serega3453/open-hotas/Models/Main-board/FCStd/Main_board_case.FCStd

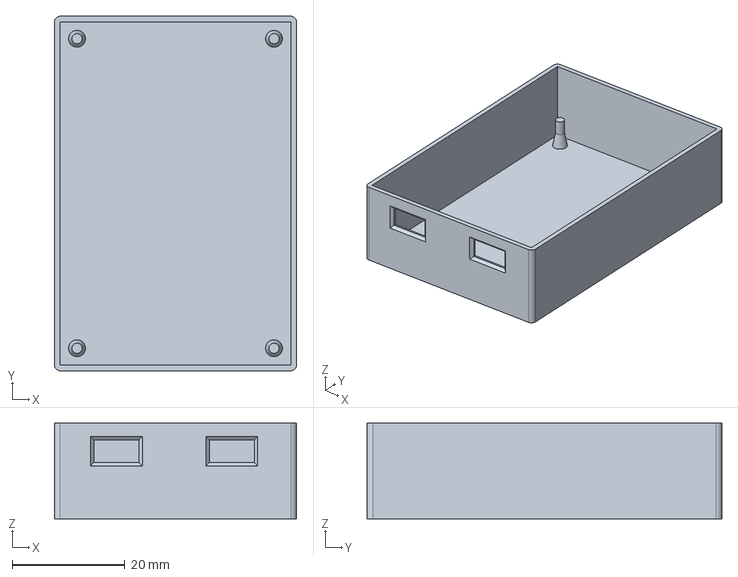
[picture p1: CAD file, 2026-10-18]
Models/Main-board/FCStd/Main_board_case.FCStd
43.0 x 63.0 x 17.0 mm
