serega3453/open-hotas/Models/Stick/FCStd/Main_stick_alternative.FCStd

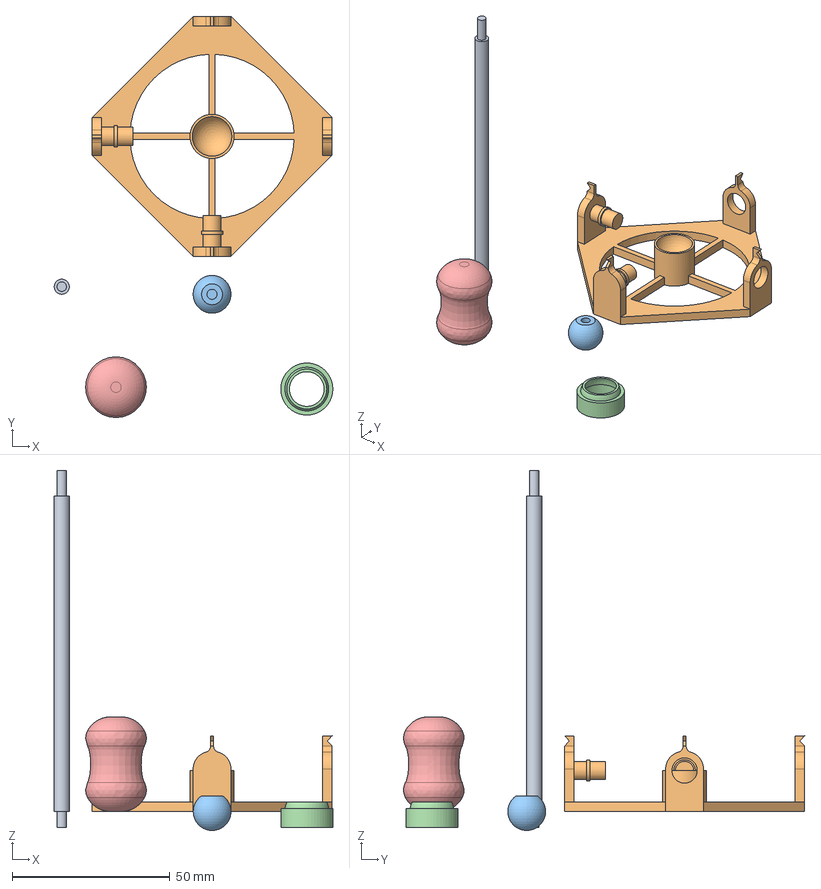
[picture p2: CAD file, 2026-10-15]
Models/Stick/FCStd/Main_stick_alternative.FCStd
88.2 x 127.0 x 114.0 mm
Stick_alt
Base
Stick_ball
Stick_ball_bracket
Stick_knob
