serega3453/open-hotas/Models/Selector-panel/FCStd/Joystick_module.FCStd

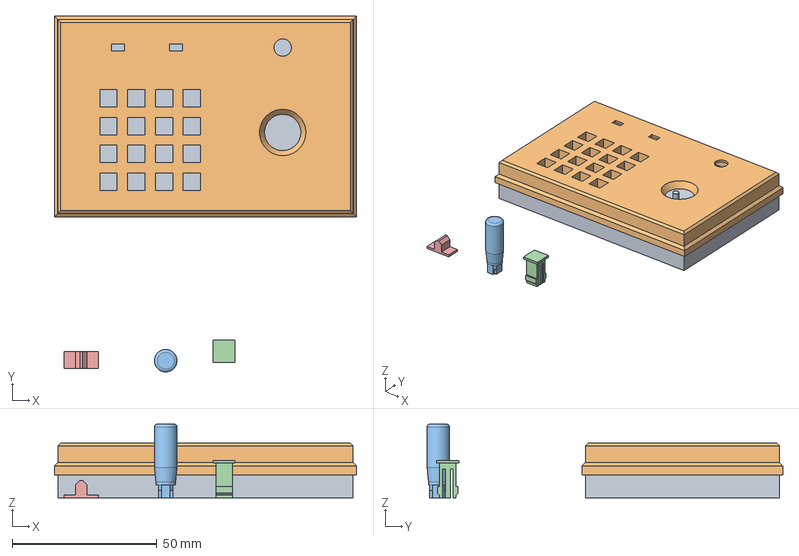
[picture p3: CAD file, 2026-10-10]
Models/Selector-panel/FCStd/Joystick_module.FCStd
104.4 x 122.9 x 25.5 mm
Cover
Stick
Plunger
Slider
