serega3453/open-hotas/Models/Stick/FCStd/New/Ergonomic_handle.FCStd

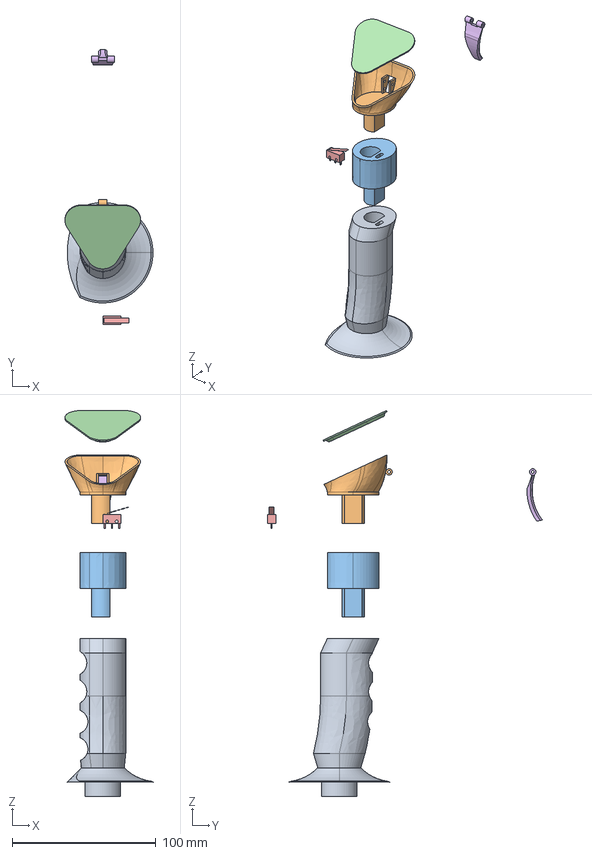
[picture p4: CAD file, 2026-11-05]
Models/Stick/FCStd/New/Ergonomic_handle.FCStd
61.3 x 191.5 x 268.8 mm
Ergonomic_handle
Erghonomic_handle_head
Ergonomic_handle_extender
Ergonomic_handle_head_cover
Microswitch
Trigger
