serega3453/open-hotas/Models/Stick/FCStd/potentiometer.FCStd

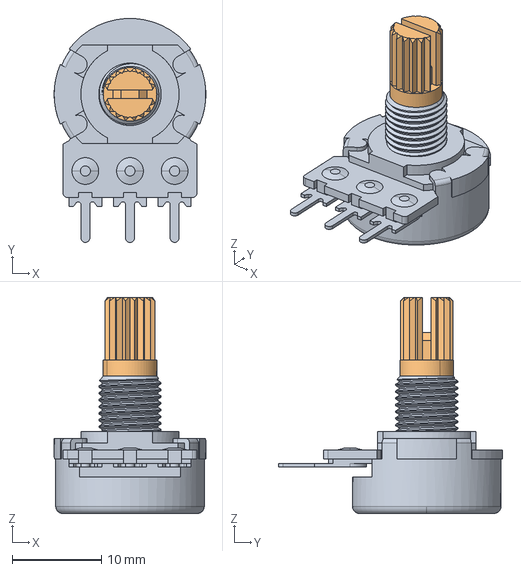
[picture p5: CAD file, 2026-11-04]
Models/Stick/FCStd/potentiometer.FCStd
17.0 x 25.1 x 24.2 mm
Slice005.10
