serega3453/open-hotas/Models/Stick/STL/Arcs/Outer_arc.stl

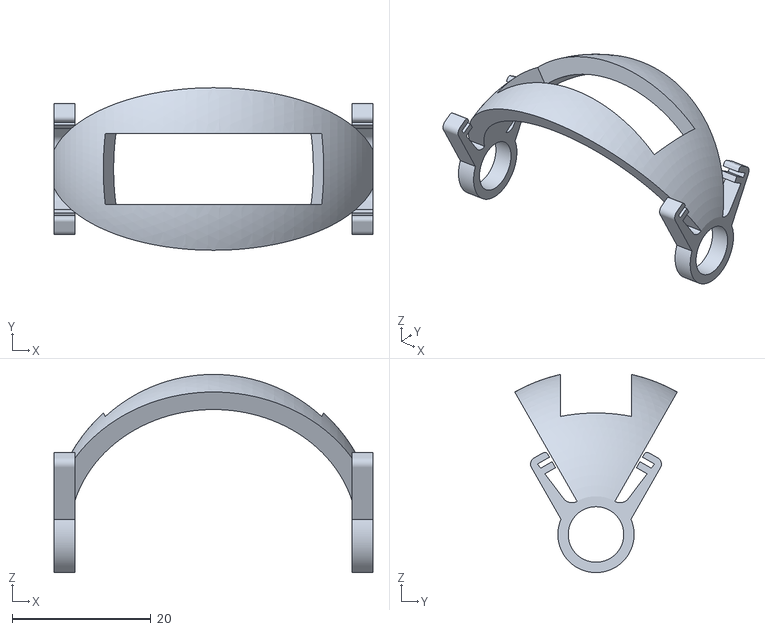
[picture p6: CAD file, 2026-11-04]
Models/Stick/STL/Arcs/Outer_arc.stl
46.0 x 23.4 x 28.6
