serega3453/open-hotas/Models/Stick/STL/Base/Axle_insert.stl

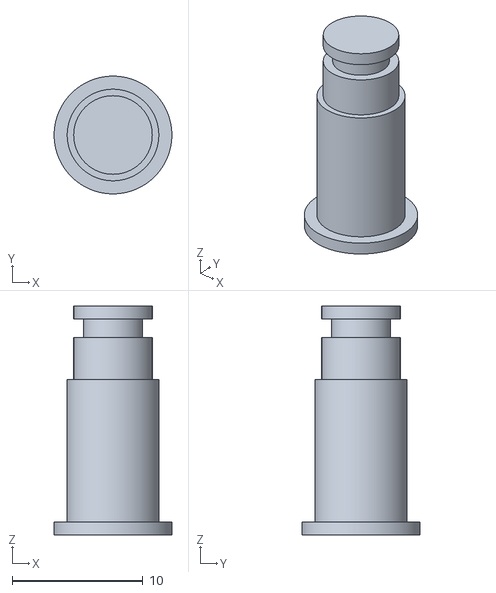
[picture p7: CAD file, 2026-11-01]
Models/Stick/STL/Base/Axle_insert.stl
9.00 x 9.00 x 17.5
