serega3453/open-hotas/Models/Stick/STL/Case/Cover.stl

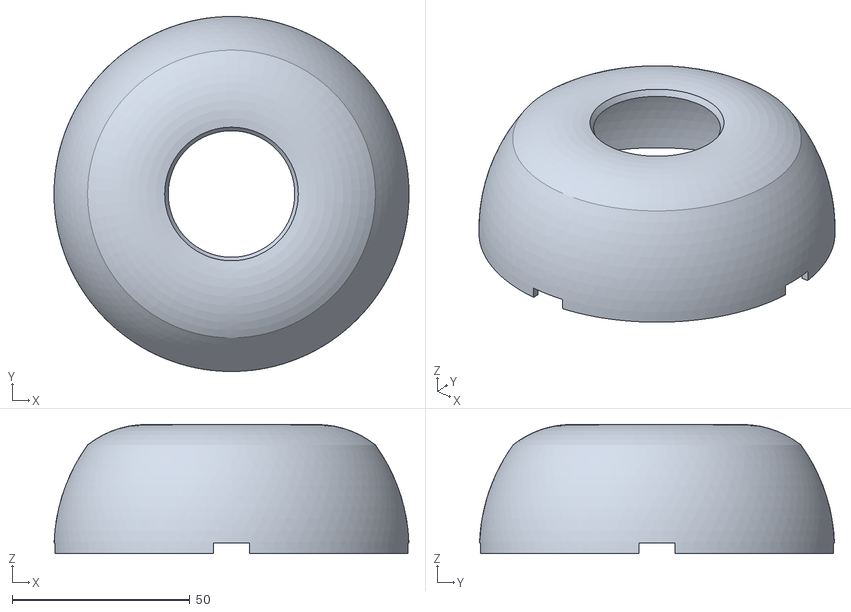
[picture p8: CAD file, 2026-11-05]
Models/Stick/STL/Case/Cover.stl
99.8 x 99.8 x 36.3
