serega3453/open-hotas/Models/Stick/STL/Ergonomic_handle/Erghonomic_handle_head.stl

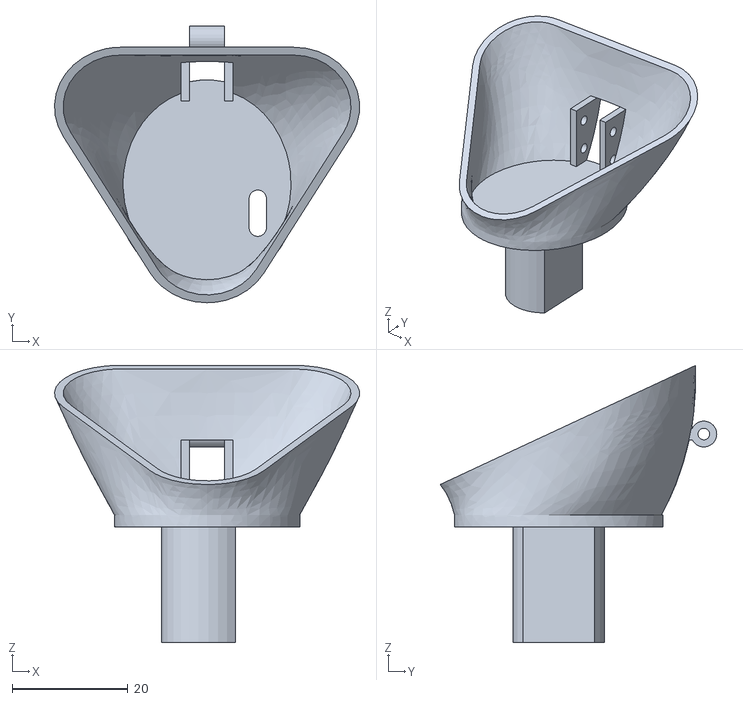
[picture p9: CAD file, 2026-11-05]
Models/Stick/STL/Ergonomic_handle/Erghonomic_handle_head.stl
52.6 x 47.7 x 47.9
