serega3453/open-hotas/Models/Stick/STL/Stick_shaft/Ball.stl

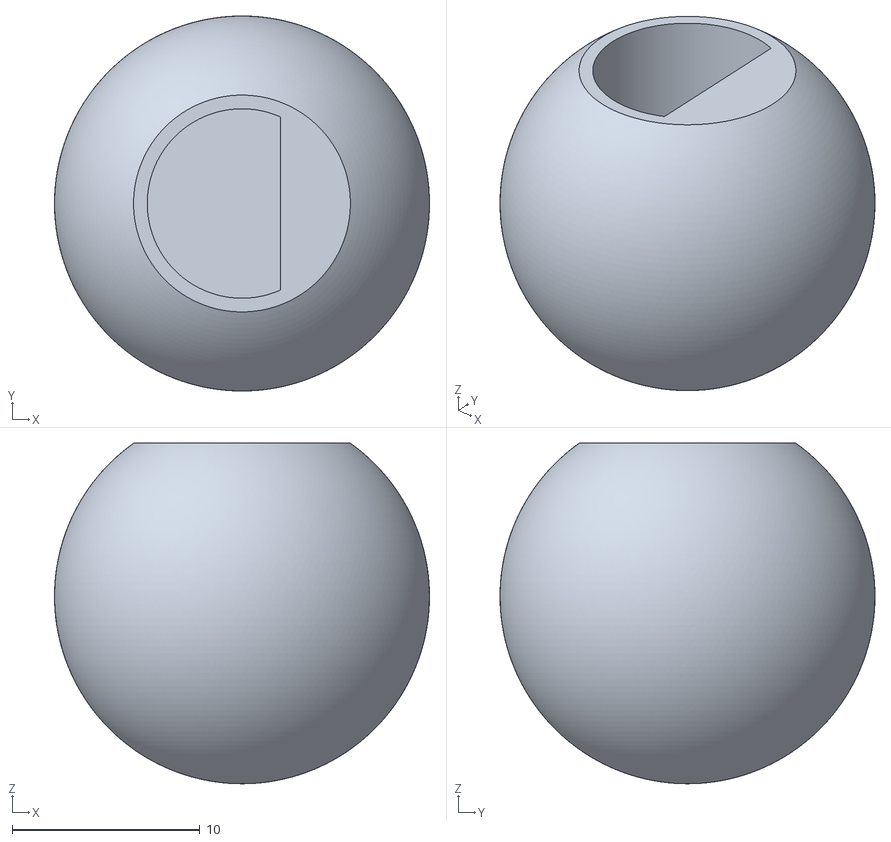
[picture p10: CAD file, 2026-11-01]
Models/Stick/STL/Stick_shaft/Ball.stl
20.0 x 20.0 x 18.2
