serega3453/open-hotas/Models/Stick/FCStd/New/Case.FCStd

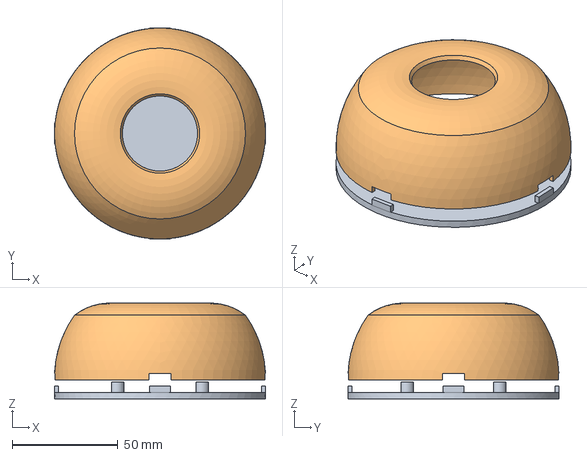
[picture p11: CAD file, 2026-11-05]
Models/Stick/FCStd/New/Case.FCStd
99.9 x 99.9 x 45.3 mm
Base
Cover
