serega3453/open-hotas/Models/Stick/FCStd/Stick_handle.FCStd

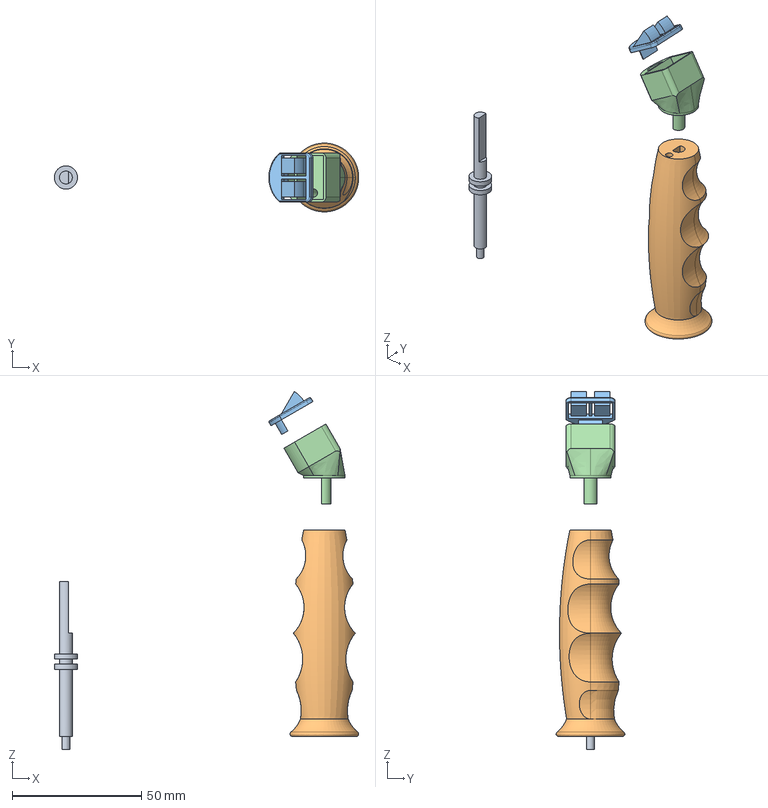
[picture p12: CAD file, 2026-10-16]
Models/Stick/FCStd/Stick_handle.FCStd
117.8 x 26.6 x 138.5 mm
Shaft
Handle
Head_cover
Head_base
