serega3453/open-hotas/Models/Stick/STL/Arcs/Bushing.stl

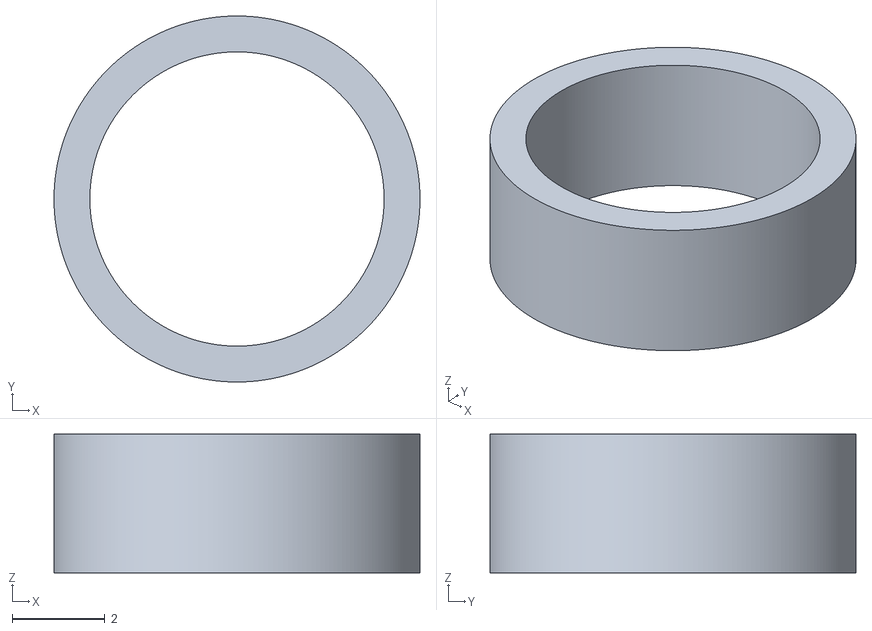
[picture p13: CAD file, 2026-11-01]
Models/Stick/STL/Arcs/Bushing.stl
7.90 x 7.90 x 3.00
