serega3453/open-hotas/Models/Stick/STL/Base/Ball_bracket.stl

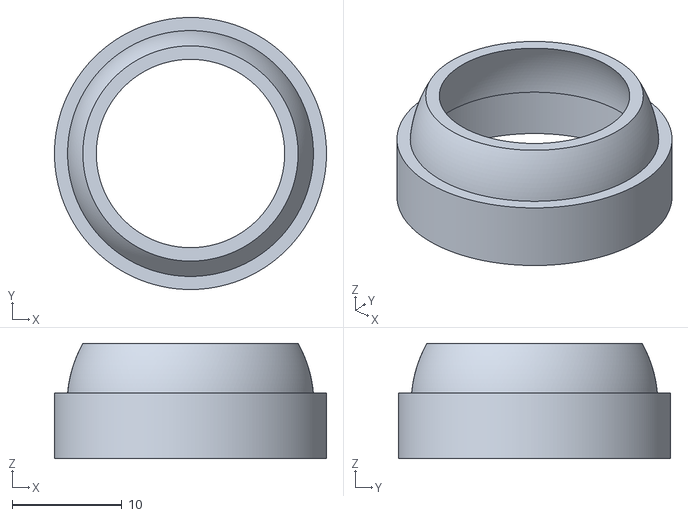
[picture p14: CAD file, 2026-11-01]
Models/Stick/STL/Base/Ball_bracket.stl
24.8 x 24.8 x 10.5
