serega3453/open-hotas/Models/Stick/STL/Case/Base.stl

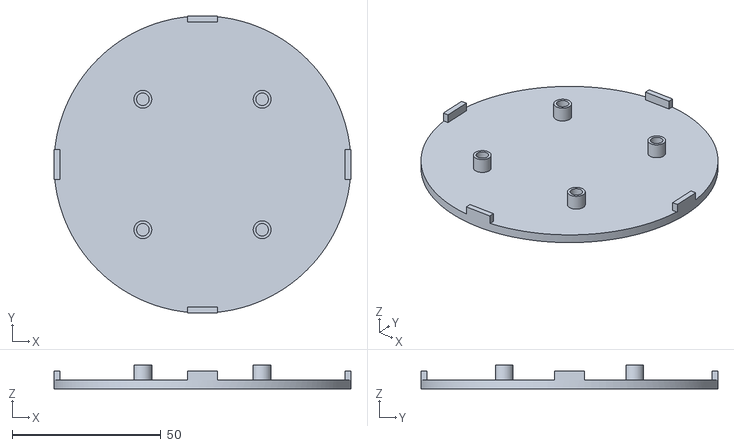
[picture p15: CAD file, 2026-11-05]
Models/Stick/STL/Case/Base.stl
99.9 x 99.9 x 8.00
