serega3453/open-hotas/Models/Stick/STL/Ergonomic_handle/Trigger.stl

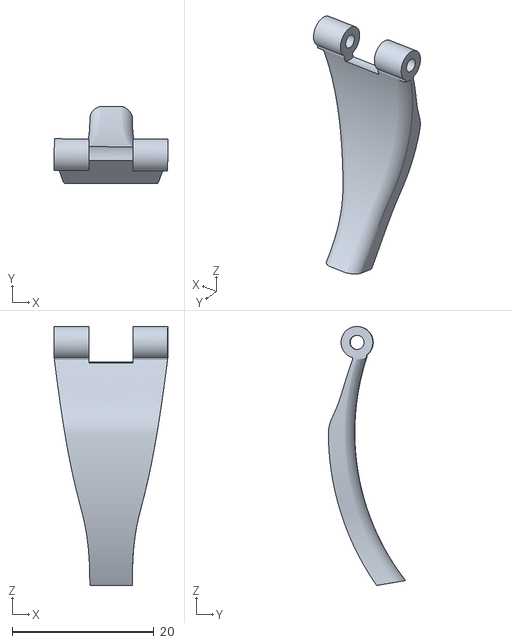
[picture p16: CAD file, 2026-11-01]
Models/Stick/STL/Ergonomic_handle/Trigger.stl
16.0 x 10.9 x 36.5
