serega3453/open-hotas/Models/Stick/STL/Stick_shaft/Shaft.stl

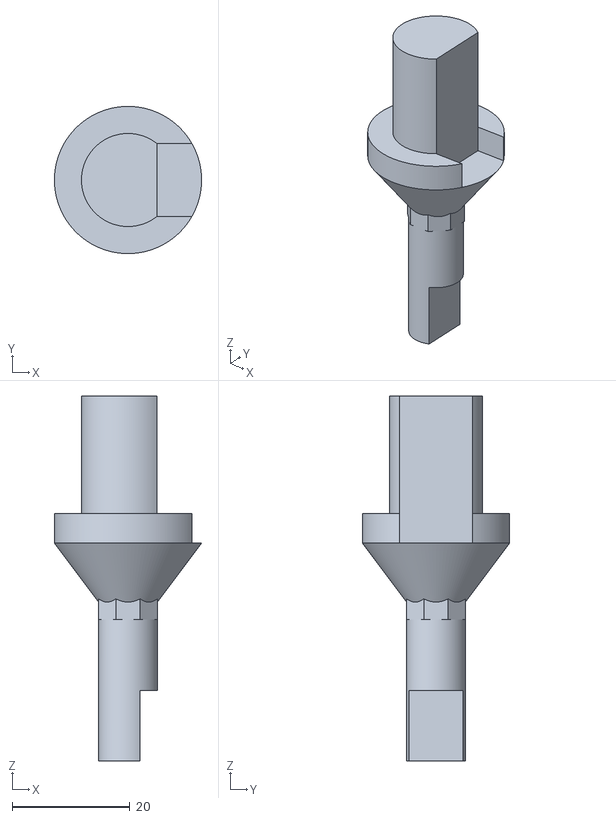
[picture p17: CAD file, 2026-11-01]
Models/Stick/STL/Stick_shaft/Shaft.stl
25.0 x 25.0 x 62.0
