serega3453/open-hotas/Models/Stick/STL/Arcs/Inner_arc.stl

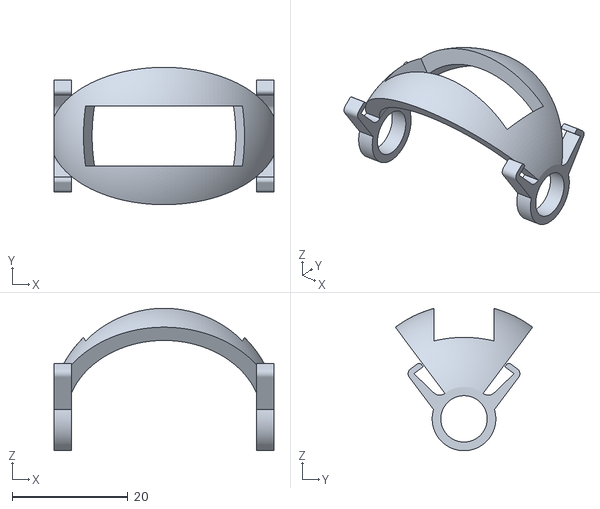
[picture p18: CAD file, 2026-11-01]
Models/Stick/STL/Arcs/Inner_arc.stl
38.0 x 23.7 x 24.6
