serega3453/open-hotas/Models/Stick/STL/Base/Ear_hole.stl

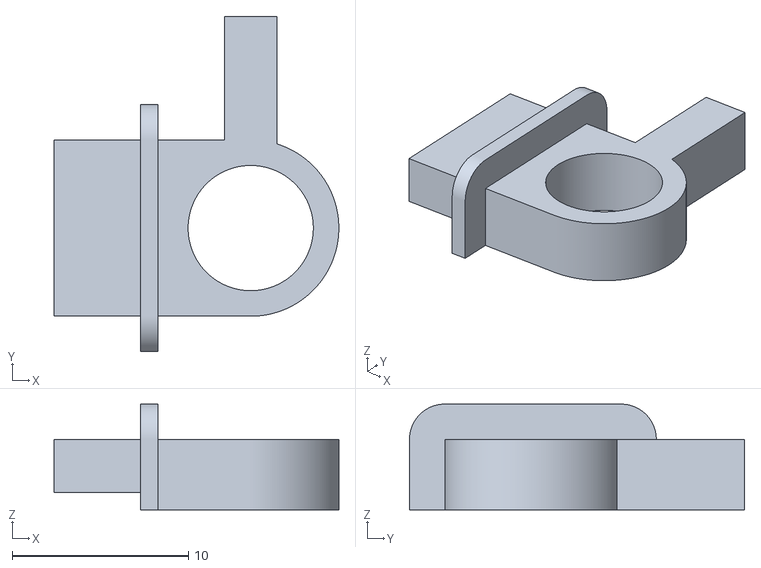
[picture p19: CAD file, 2026-11-01]
Models/Stick/STL/Base/Ear_hole.stl
16.1 x 19.0 x 6.00
