serega3453/open-hotas/Models/Stick/STL/Ergonomic_handle/Ergonomic_handle_head_cover.stl

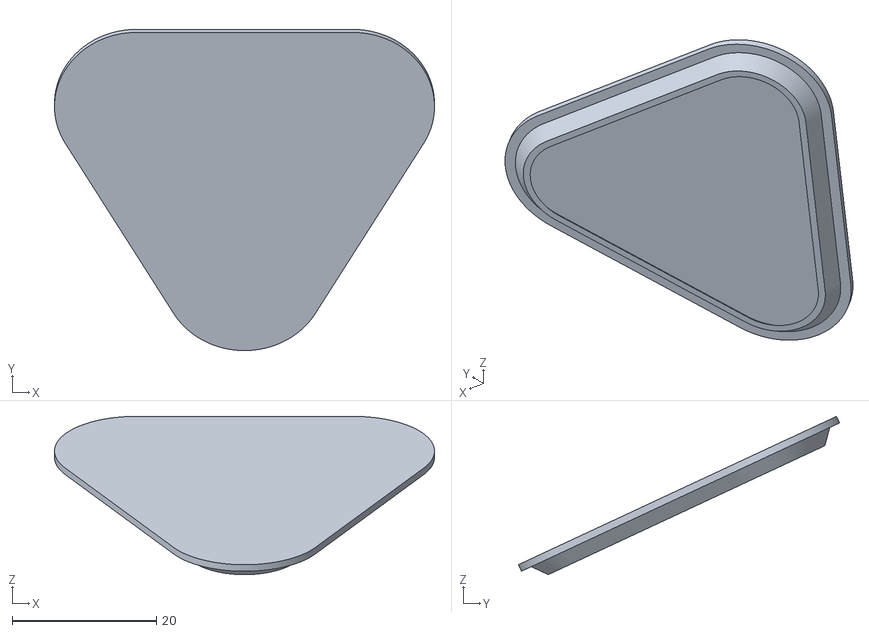
[picture p20: CAD file, 2026-11-01]
Models/Stick/STL/Ergonomic_handle/Ergonomic_handle_head_cover.stl
52.7 x 44.5 x 21.9
