serega3453/open-hotas/Models/Stick/FCStd/New/Stick_shaft.FCStd

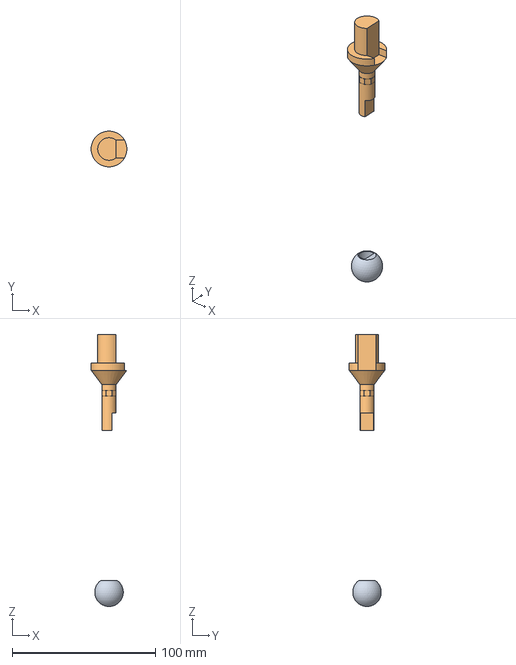
[picture p21: CAD file, 2026-11-05]
Models/Stick/FCStd/New/Stick_shaft.FCStd
25.0 x 25.0 x 190.0 mm
Ball
Shaft
