serega3453/open-hotas/Models/Stick/STL/Base/Pot_fixator.stl

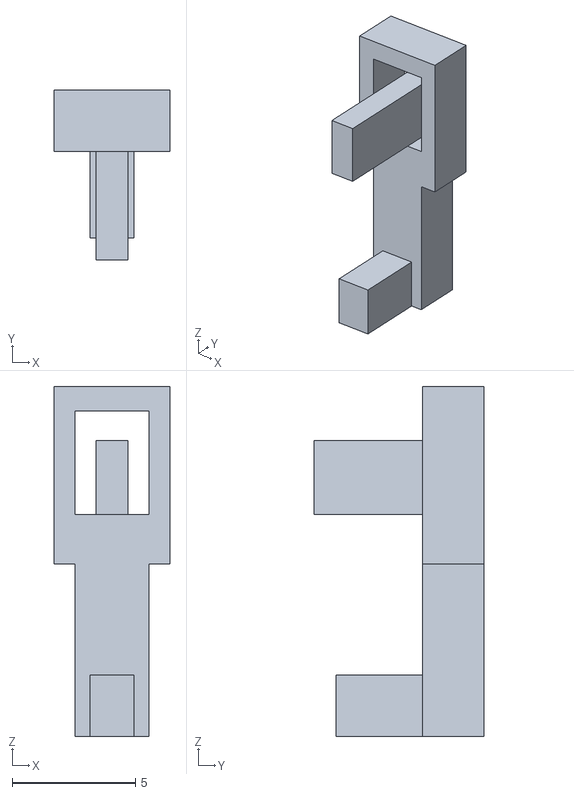
[picture p23: CAD file, 2026-11-01]
Models/Stick/STL/Base/Pot_fixator.stl
4.70 x 6.90 x 14.2
