serega3453/open-hotas/Models/Stick/STL/Ergonomic_handle/Ergonomic_handle.stl

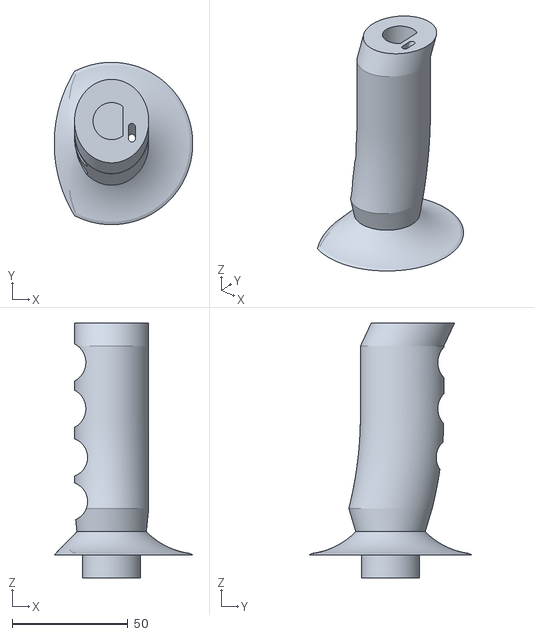
[picture p24: CAD file, 2026-11-01]
Models/Stick/STL/Ergonomic_handle/Ergonomic_handle.stl
59.7 x 70.0 x 110.0
