serega3453/open-hotas/Models/Stick/FCStd/Concentric_arcs.FCStd

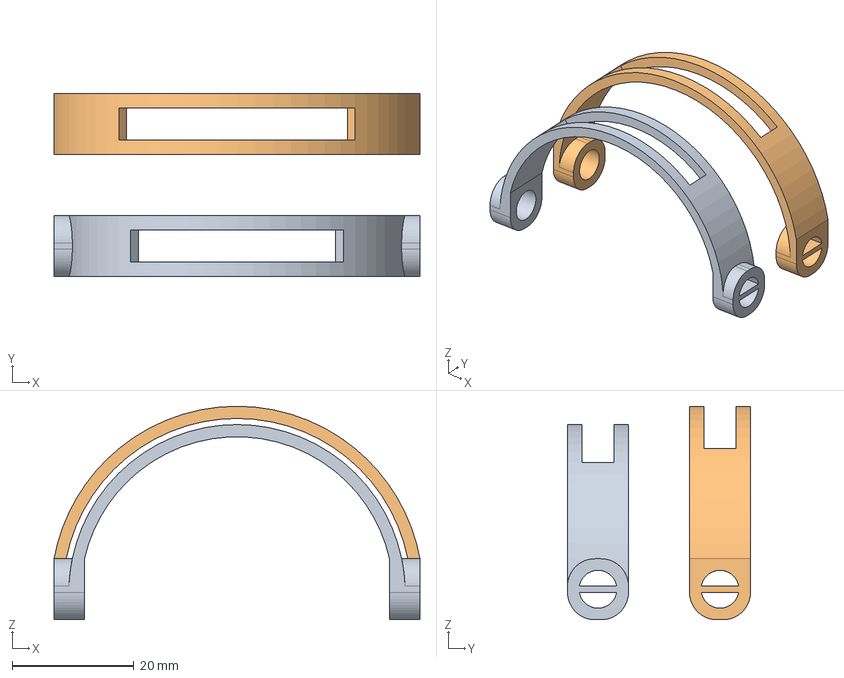
[picture p25: CAD file, 2026-10-15]
Models/Stick/FCStd/Concentric_arcs.FCStd
60.0 x 30.0 x 35.0 mm
Inner_arc
Outer_arc
