serega3453/open-hotas/Models/Stick/FCStd/New/Base.FCStd

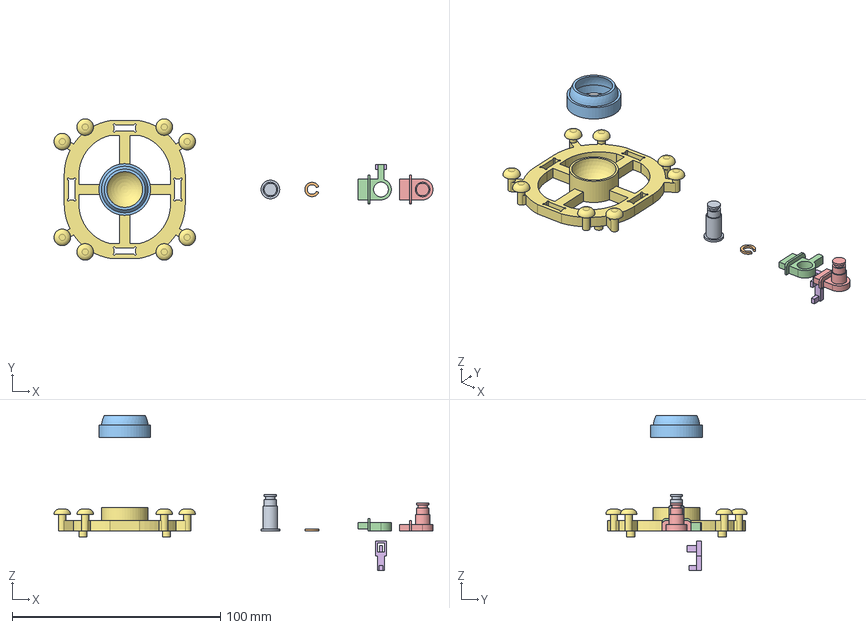
[picture p26: CAD file, 2026-11-05]
Models/Stick/FCStd/New/Base.FCStd
182.1 x 68.0 x 74.5 mm
Axle_insert
Retaining_ring
Ball_bracket
Ear_hole
Ear_axle
Pot_fixator
Stand
