serega3453/open-hotas/Models/Stick/STL/Arcs/Tool.stl

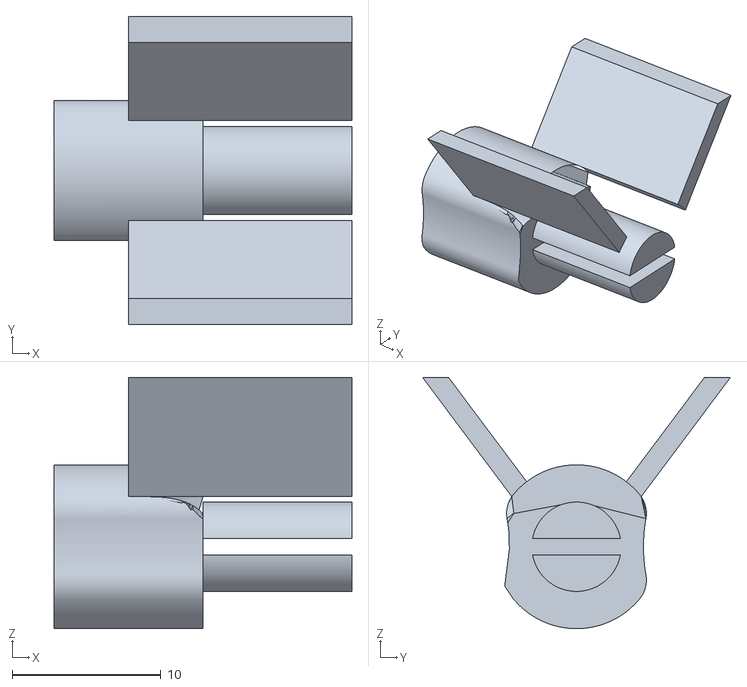
[picture p27: CAD file, 2026-11-01]
Models/Stick/STL/Arcs/Tool.stl
20.0 x 20.7 x 16.9
