serega3453/open-hotas/Models/Stick/STL/Base/Retaining_ring.stl

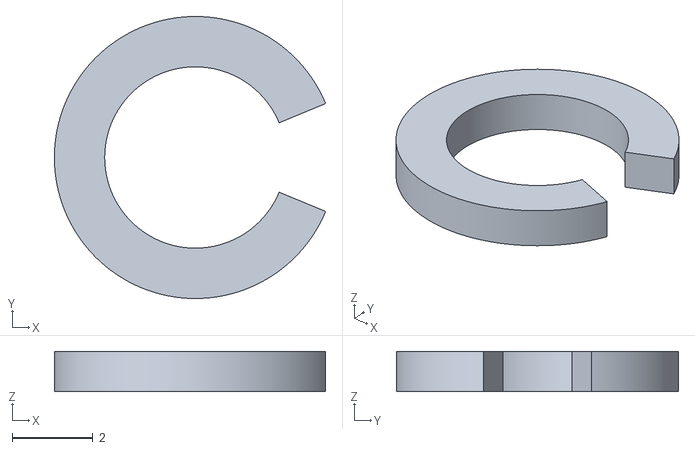
[picture p28: CAD file, 2026-11-01]
Models/Stick/STL/Base/Retaining_ring.stl
6.73 x 7.00 x 1.00
