serega3453/open-hotas/Models/Stick/STL/Ergonomic_handle/Microswitch.stl

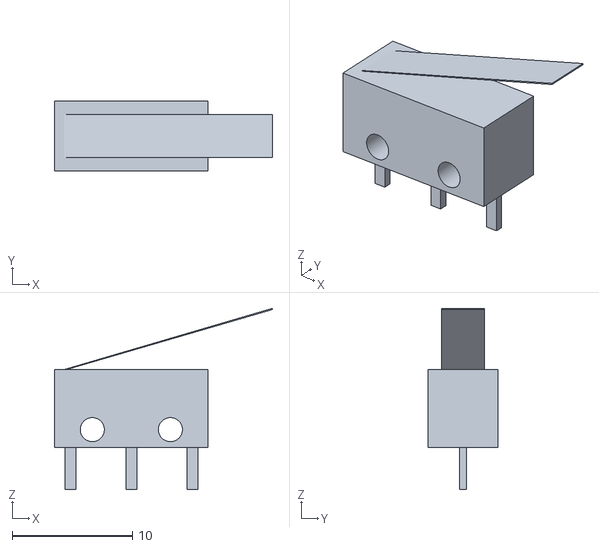
[picture p29: CAD file, 2026-11-01]
Models/Stick/STL/Ergonomic_handle/Microswitch.stl
18.1 x 5.80 x 15.1
