serega3453/open-hotas/Models/Stick/FCStd/New/Arcs.FCStd

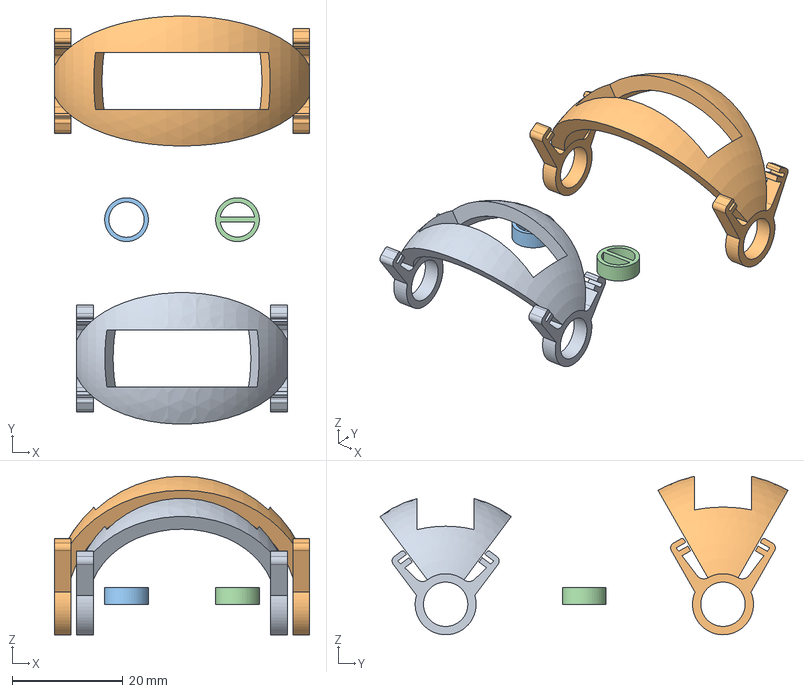
[picture p30: CAD file, 2026-11-03]
Models/Stick/FCStd/New/Arcs.FCStd
46.0 x 73.6 x 28.6 mm
Inner_arc
Outer_arc
Bushing
Bushing_slotted
