serega3453/open-hotas/Models/Stick/STL/Base/Stand.stl

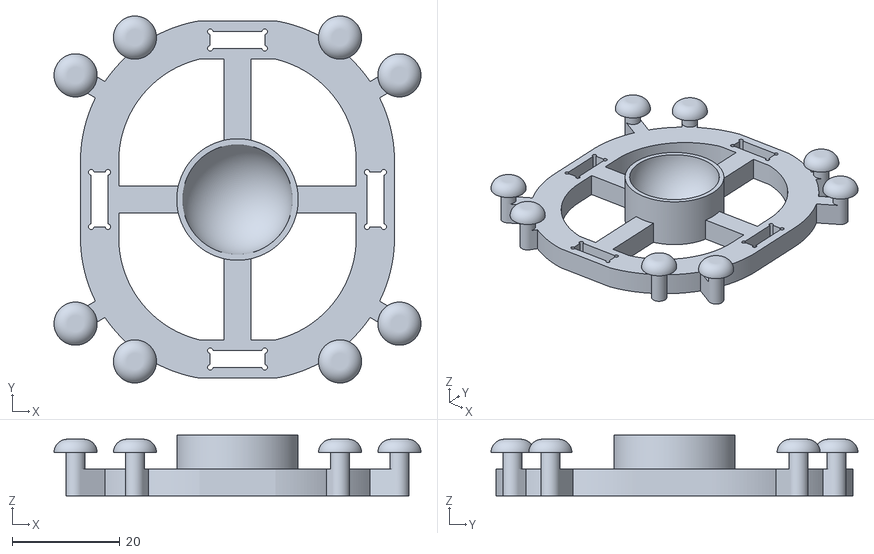
[picture p31: CAD file, 2026-11-01]
Models/Stick/STL/Base/Stand.stl
68.0 x 68.0 x 11.2
