serega3453/open-hotas/Models/Stick/STL/Ergonomic_handle/Ergonomic_handle_extender.stl

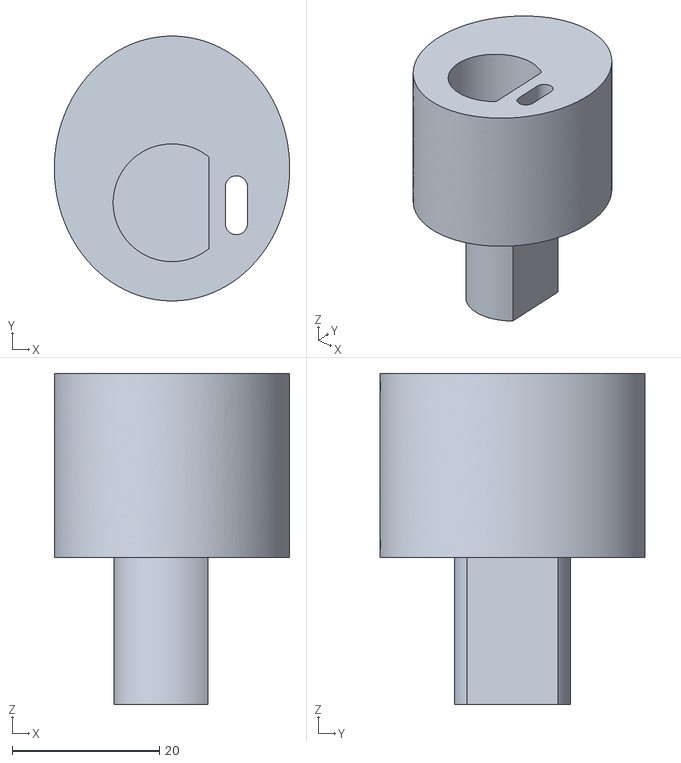
[picture p32: CAD file, 2026-11-01]
Models/Stick/STL/Ergonomic_handle/Ergonomic_handle_extender.stl
32.0 x 36.0 x 45.0
