serega3453/open-hotas/Models/Stick/STL/Base/Ear_axle.stl

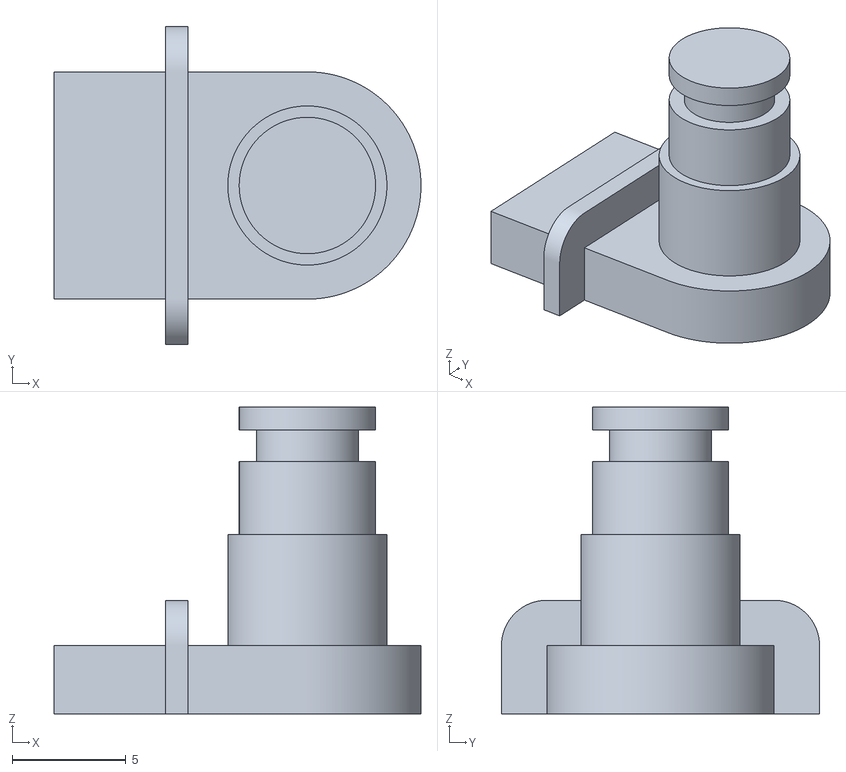
[picture p33: CAD file, 2026-11-01]
Models/Stick/STL/Base/Ear_axle.stl
16.1 x 14.0 x 13.5
