serega3453/open-hotas/(list of files, cad)

Other CAD files:
Models/Main-board/STL/Main_board_case-Bottom_half.stl
Models/Stick/FCStd/Joystick_assembly.FCStd
Models/Stick/FCStd/New/Assembly.FCStd
Models/Stick/FCStd/Old/Concentric_arcs.FCStd
Models/Stick/FCStd/Old/Joystick_assembly.FCStd
Models/Stick/STEP/R16148-1A-2-B5K--3DModel-STEP-510211.STEP
