serega3453/open-hotas/(commit log)

2026-10-09 added hardware directory
    [IO_shift_registers.kicad_sch, control-stick.kicad_sch, esp32_variant.kicad_sch, mh-module.kicad_sch, pro-micro_hub.kicad_sch, selector-panel.kicad_sch, stick.kicad_pcb, stick.kicad_sch]
2026-10-09 added models directory
    [Concentric_arcs.FCStd, Joystick_assembly.FCStd, Main_stick_alternative.FCStd]
2026-10-09 added shared code space, added calibration function to Rx/Ry along with indication
2026-10-10 arc movement angle lowered from 90 to 80 degree swing, distance between arcs lowered from 2mm to 1mm, spherical joint bracket skirt extended from 2mm to 4mm
    [Concentric_arcs.FCStd, Joystick_assembly.FCStd, Main_stick_alternative.FCStd]
2026-10-10 reorganized model folder hierarchy, added exported STL files (except the top handle)
    [Concentric_arcs-Inner_arc.stl, Concentric_arcs-Outer_arc.stl, Concentric_arcs.FCStd, Joystick_assembly.FCStd, Main_stick_alternative-Base.stl, Main_stick_alternative-Stick_alt.stl, Main_stick_alternative-Stick_ball.stl, Main_stick_alternative-Stick_ball_bracket.stl]
2026-10-10 added selector panel FCStd files
    [Joystick_module.FCStd]
2026-10-10 ema filter <0 fix, ema coef changed from 3 to 2
    [main.cpp]
2026-10-11 ball bracket straight walls thickened from 0.5mm to 1mm, started the new handle design (shaft with D-slot added), ball slot hole diameter widened from 3.2mm to 3.3mm as for all 3mm holes in the proje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
    [Concentric_arcs.FCStd, Joystick_assembly.FCStd, Main_stick_alternative-Stick_ball.stl, Main_stick_alternative-Stick_ball_bracket.stl, Main_stick_alternative.FCStd, Stick_handle-Shaft.stl, Stick_handle.FCStd]
2026-10-12 added rubber bands slots on the base
    [Concentric_arcs.FCStd, Joystick_assembly.FCStd, Main_stick_alternative.FCStd]
2026-10-12 stick shaft length increased from 50mm to 60mm
    [Stick_handle.FCStd]
2026-10-12 added rubber band slot on the stick shaft
    [Stick_handle.FCStd]
2026-10-12 fixed flipped arc in assembly
    [Joystick_assembly.FCStd]
2026-10-12 widened and moved the rubber band slot on the stick shaft, stick shaft added in the assembly
    [Joystick_assembly.FCStd, Stick_handle.FCStd]
2026-10-12 ball bracket skirt length increased from 4mm to 5mm
    [Main_stick_alternative.FCStd]
2026-10-12 ball hole narrowed from 3.3mm to 3.2mm, stick shaft rubber band bracket chamfer removed due to printing issues
    [Joystick_assembly.FCStd, Main_stick_alternative-Base.stl, Main_stick_alternative-Stick_ball.stl, Main_stick_alternative-Stick_ball_bracket.stl, Main_stick_alternative.FCStd, Stick_handle-Shaft.stl, Stick_handle.FCStd]
2026-10-13 added ribbed handle
    [Concentric_arcs-Inner_arc.stl, Concentric_arcs-Outer_arc.stl, Concentric_arcs.FCStd, Joystick_assembly.FCStd, Main_stick_alternative.FCStd, Stick_handle.FCStd]
2026-10-13 handle D-hole widened from 5mm to 5.2mm, added handle .stl
    [Joystick_assembly.FCStd, Stick_handle-Handle.stl, Stick_handle.FCStd]
2026-10-14 better stick handle ergonomics design
    [Joystick_assembly.FCStd, Main_stick_alternative.FCStd, Stick_handle.FCStd]
2026-10-14 chamfer added to stick handle base, cable compartment cutout in stick handle
    [Stick_handle.FCStd]
2026-10-14 added recent changes into assembly file
    [Joystick_assembly.FCStd]
2026-10-14 added the base of a head module to the stick
    [Joystick_assembly.FCStd, Stick_handle-Handle.stl, Stick_handle.FCStd]
2026-10-15 added SPI port on the schematic, added .history in .gitignore
    [pro-micro_hub.kicad_sch]
2026-10-15 work on stick head
    [Joystick_assembly.FCStd, Stick_handle.FCStd]
2026-10-15 added stick head assembly
    [Joystick_assembly.FCStd, Stick_handle-Head_base.stl, Stick_handle.FCStd]
2026-10-15 stick head assembly sockets and pins correction
    [Joystick_assembly.FCStd, Stick_handle.FCStd]
2026-10-15 added stick head to the assembly
    [Concentric_arcs.FCStd, Joystick_assembly-Assembly.stl, Joystick_assembly.FCStd, Main_stick_alternative.FCStd, Stick_handle-Head_base.stl, Stick_handle-Head_cover.stl, Stick_handle.FCStd]
2026-10-16 started the development of the ergonomic handle
    [Ergonomic_handle.FCStd, Joystick_assembly.FCStd]
2026-10-16 work on ergonomical handle continues
    [Ergonomic_handle.FCStd, Joystick_assembly.FCStd, Stick_handle.FCStd]
2026-10-18 continue work on ergonomic handle, added bottom half of the main board case model
    [Ergonomic_handle-Ergonomic_handle.stl, Ergonomic_handle.FCStd, Ergonomic_handle.stl, Main_board_case-Bottom_half.stl, Main_board_case.FCStd]
2026-10-18 continue working on ergonomic handle
    [Ergonomic_handle-Ergonomic_handle.stl, Ergonomic_handle-PartErghonomic_handle_head.stl, Ergonomic_handle-PartErgonomic_handle.stl, Ergonomic_handle-PartErgonomic_handle_extender.stl, Ergonomic_handle.FCStd, Ergonomic_handle.stl]
2026-10-19 corrected ergonomical handle head cover geometry, added microswitch KW10-Z2P model
    [Ergonomic_handle.FCStd]
2026-10-20 continue work on ergonomical handle
    [Ergonomic_handle-PartErghonomic_handle_head.stl, Ergonomic_handle-PartErgonomic_handle_head_cover.stl, Ergonomic_handle.FCStd]
2026-10-20 added trigger to ergonomical handle
    [Ergonomic_handle-PartErghonomic_handle_head.stl, Ergonomic_handle-PartTrigger.stl, Ergonomic_handle.FCStd]
2026-10-21 continue working on ergonomical handle
    [Ergonomic_handle-PartErgonomic_handle_head_cover.stl, Ergonomic_handle-PartTrigger.stl, Ergonomic_handle.FCStd]
2026-10-22 added ball and shaft to stick file
    [Ergonomic_handle.FCStd, Stick_shaft.FCStd]
2026-10-23 added new/old stick division, added new stick assembly, new stick ball joint
    [Assembly.FCStd, Concentric_arcs.FCStd, Ergonomic_handle-PartErgonomic_handle_head_cover.stl, Ergonomic_handle.FCStd, Joystick_assembly.FCStd, Main_stick_alternative.FCStd, Stick_handle.FCStd, Stick_shaft.FCStd]
2026-10-23 added new arc file
    [Arcs.FCStd, Assembly-AssemblyBall001.stl, Assembly-AssemblyShaft001.stl, Assembly.FCStd, Base.FCStd, Concentric_arcs.FCStd]
2026-10-25 added a base, arc assembly tools, bushings, retaining rings, global assembly
    [Arcs-Bushing.stl, Arcs-Bushing_leveling_toolTool_stop.stl, Arcs-Bushing_levelling_tool.stl, Arcs-Bushing_slotted.stl, Arcs-Inner_arc.stl, Arcs-Outer_arc.stl, Arcs.FCStd, Assembly.FCStd]
2026-10-25 corrections for new additions
    [Arcs-Bushing.stl, Arcs-Bushing_leveling_toolTool.stl, Arcs-Bushing_slotted.stl, Arcs-Inner_arc.stl, Arcs-Outer_arc.stl, Arcs.FCStd, Assembly.FCStd, Base-Base_partAxle_insert.stl]
2026-10-27 size tolerances changes
    [Arcs-Bushing.stl, Arcs-Bushing_slotted.stl, Arcs-Inner_arc.stl, Arcs.FCStd, Assembly.FCStd, Base-Base_partRetaining_ring.stl, Base-Base_partStand.stl, Base.FCStd]
2026-10-27 changed the length of a shaft
    [Assembly.FCStd, Ergonomic_handle.FCStd, Stick_shaft.FCStd]
2026-10-28 added bushings to the base assembly
    [Assembly.FCStd, Base-Base_partAxle_insert.stl, Base-Base_partBushing.stl, Base-Base_partStand.stl, Base.FCStd, Stick_shaft-Stick_shaft_partBall.stl, Stick_shaft-Stick_shaft_partShaft.stl, Stick_shaft.FCStd]
2026-10-28 added ball bracket, changed base construction, ears are printed separately now
    [Assembly.FCStd, Base.FCStd, Stick_shaft.FCStd]
2026-10-28 assembly fixes
    [Assembly.FCStd]
2026-10-29 minor changes
    [Assembly.FCStd, Base-Base_partBall_bracket.stl, Base-Base_partEar.stl, Base-Base_partStand.stl, Base.FCStd]
2026-10-29 lowered the distance between ears, added aligning tabs for potentiometers
    [Assembly.FCStd, Base.FCStd]
2026-11-01 added tensioners, potentiometer fixators, octagonal profile on axle, minor size changes
    [Arcs-Bushing.stl, Arcs-Bushing_leveling_toolTool.stl, Arcs-Bushing_leveling_toolTool_stop.stl, Arcs-Bushing_levelling_tool.stl, Arcs-Bushing_slotted.stl, Arcs-Inner_arc.stl, Arcs-Outer_arc.stl, Arcs.FCStd]
2026-11-02 added potentiometer models
    [Assembly.FCStd, R16148-1A-2-B5K--3DModel-STEP-510211.STEP, potentiometer.FCStd]
2026-11-02 merged earlier commit with fixes to potentiometer aligner
    [Base.FCStd]
2026-11-03 fixed holders
    [Arcs.FCStd, Assembly.FCStd, Base.FCStd]
2026-11-04 added casing, second prototype
    [Assembly.FCStd, Base.FCStd, Case.FCStd, Outer_arc.stl, potentiometer.FCStd]
2026-11-05 work on case continues
    [Assembly.FCStd, Base.FCStd, Case.FCStd, Stick_shaft.FCStd]
2026-11-05 finished rudimentary case, proceeding to work on the handle head
    [Assembly.FCStd, Base.stl, Case.FCStd, Cover.stl, Erghonomic_handle_head.stl, Ergonomic_handle.FCStd, Stick_shaft.FCStd]
